rcardenes/FleaFPGA_Replica/FleaFPGA_Ohm_Replica.kicad_pcb

## KiCad design FleaFPGA_Ohm_Replica.kicad_pcb (2024-11-16)

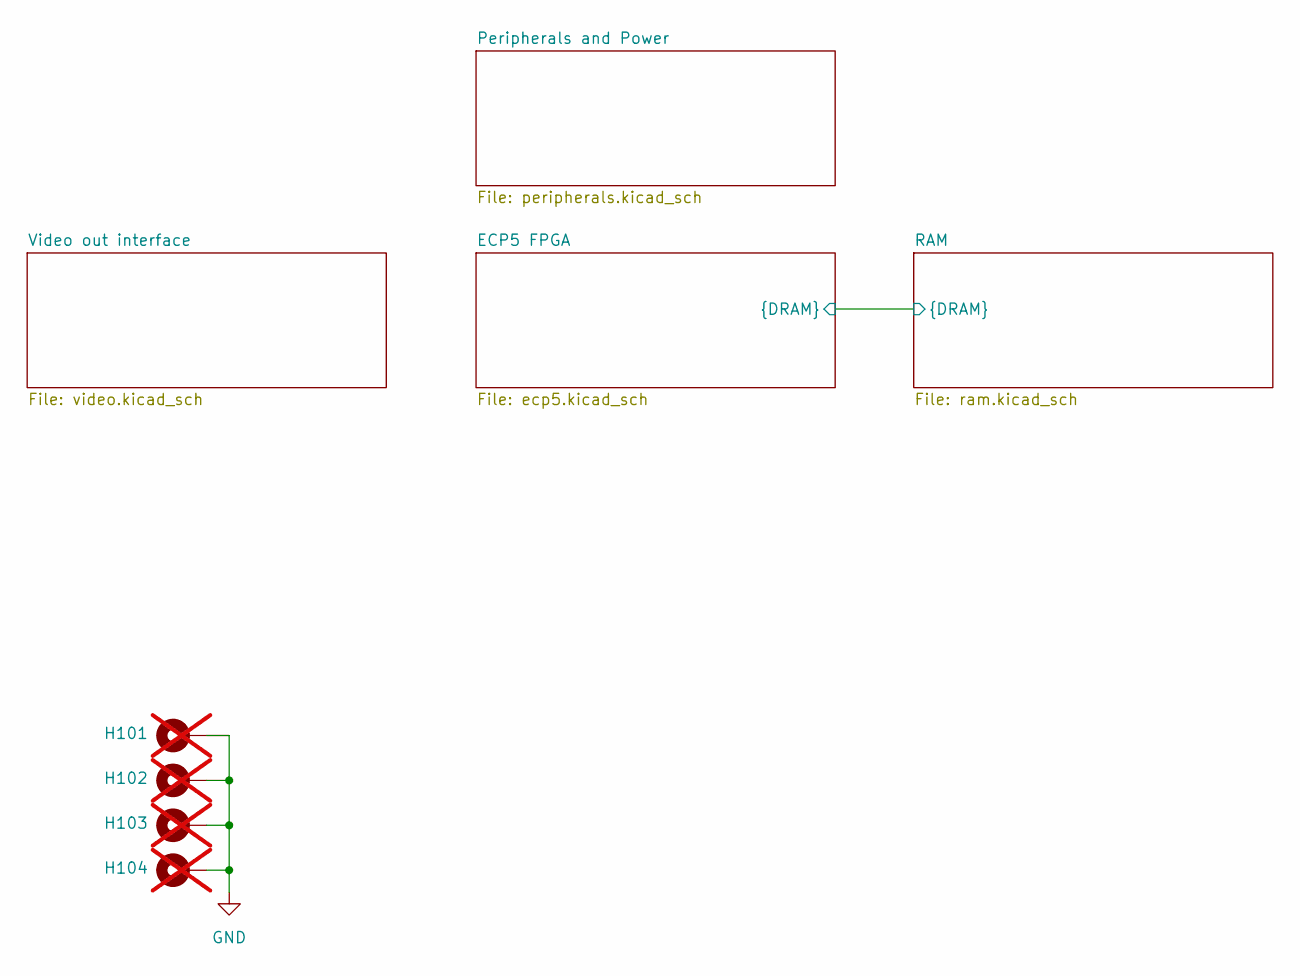
[picture p1: schematic FleaFPGA_Ohm_Replica.kicad_sch]

Parts:
H101, H102, H103, H104: MountingHole_Pad; MountingHole_2.7mm_M2.5_Pad; not fitted

Connections:
GND: H101.1, H102.1, H103.1, H104.1; also elsewhere on the board

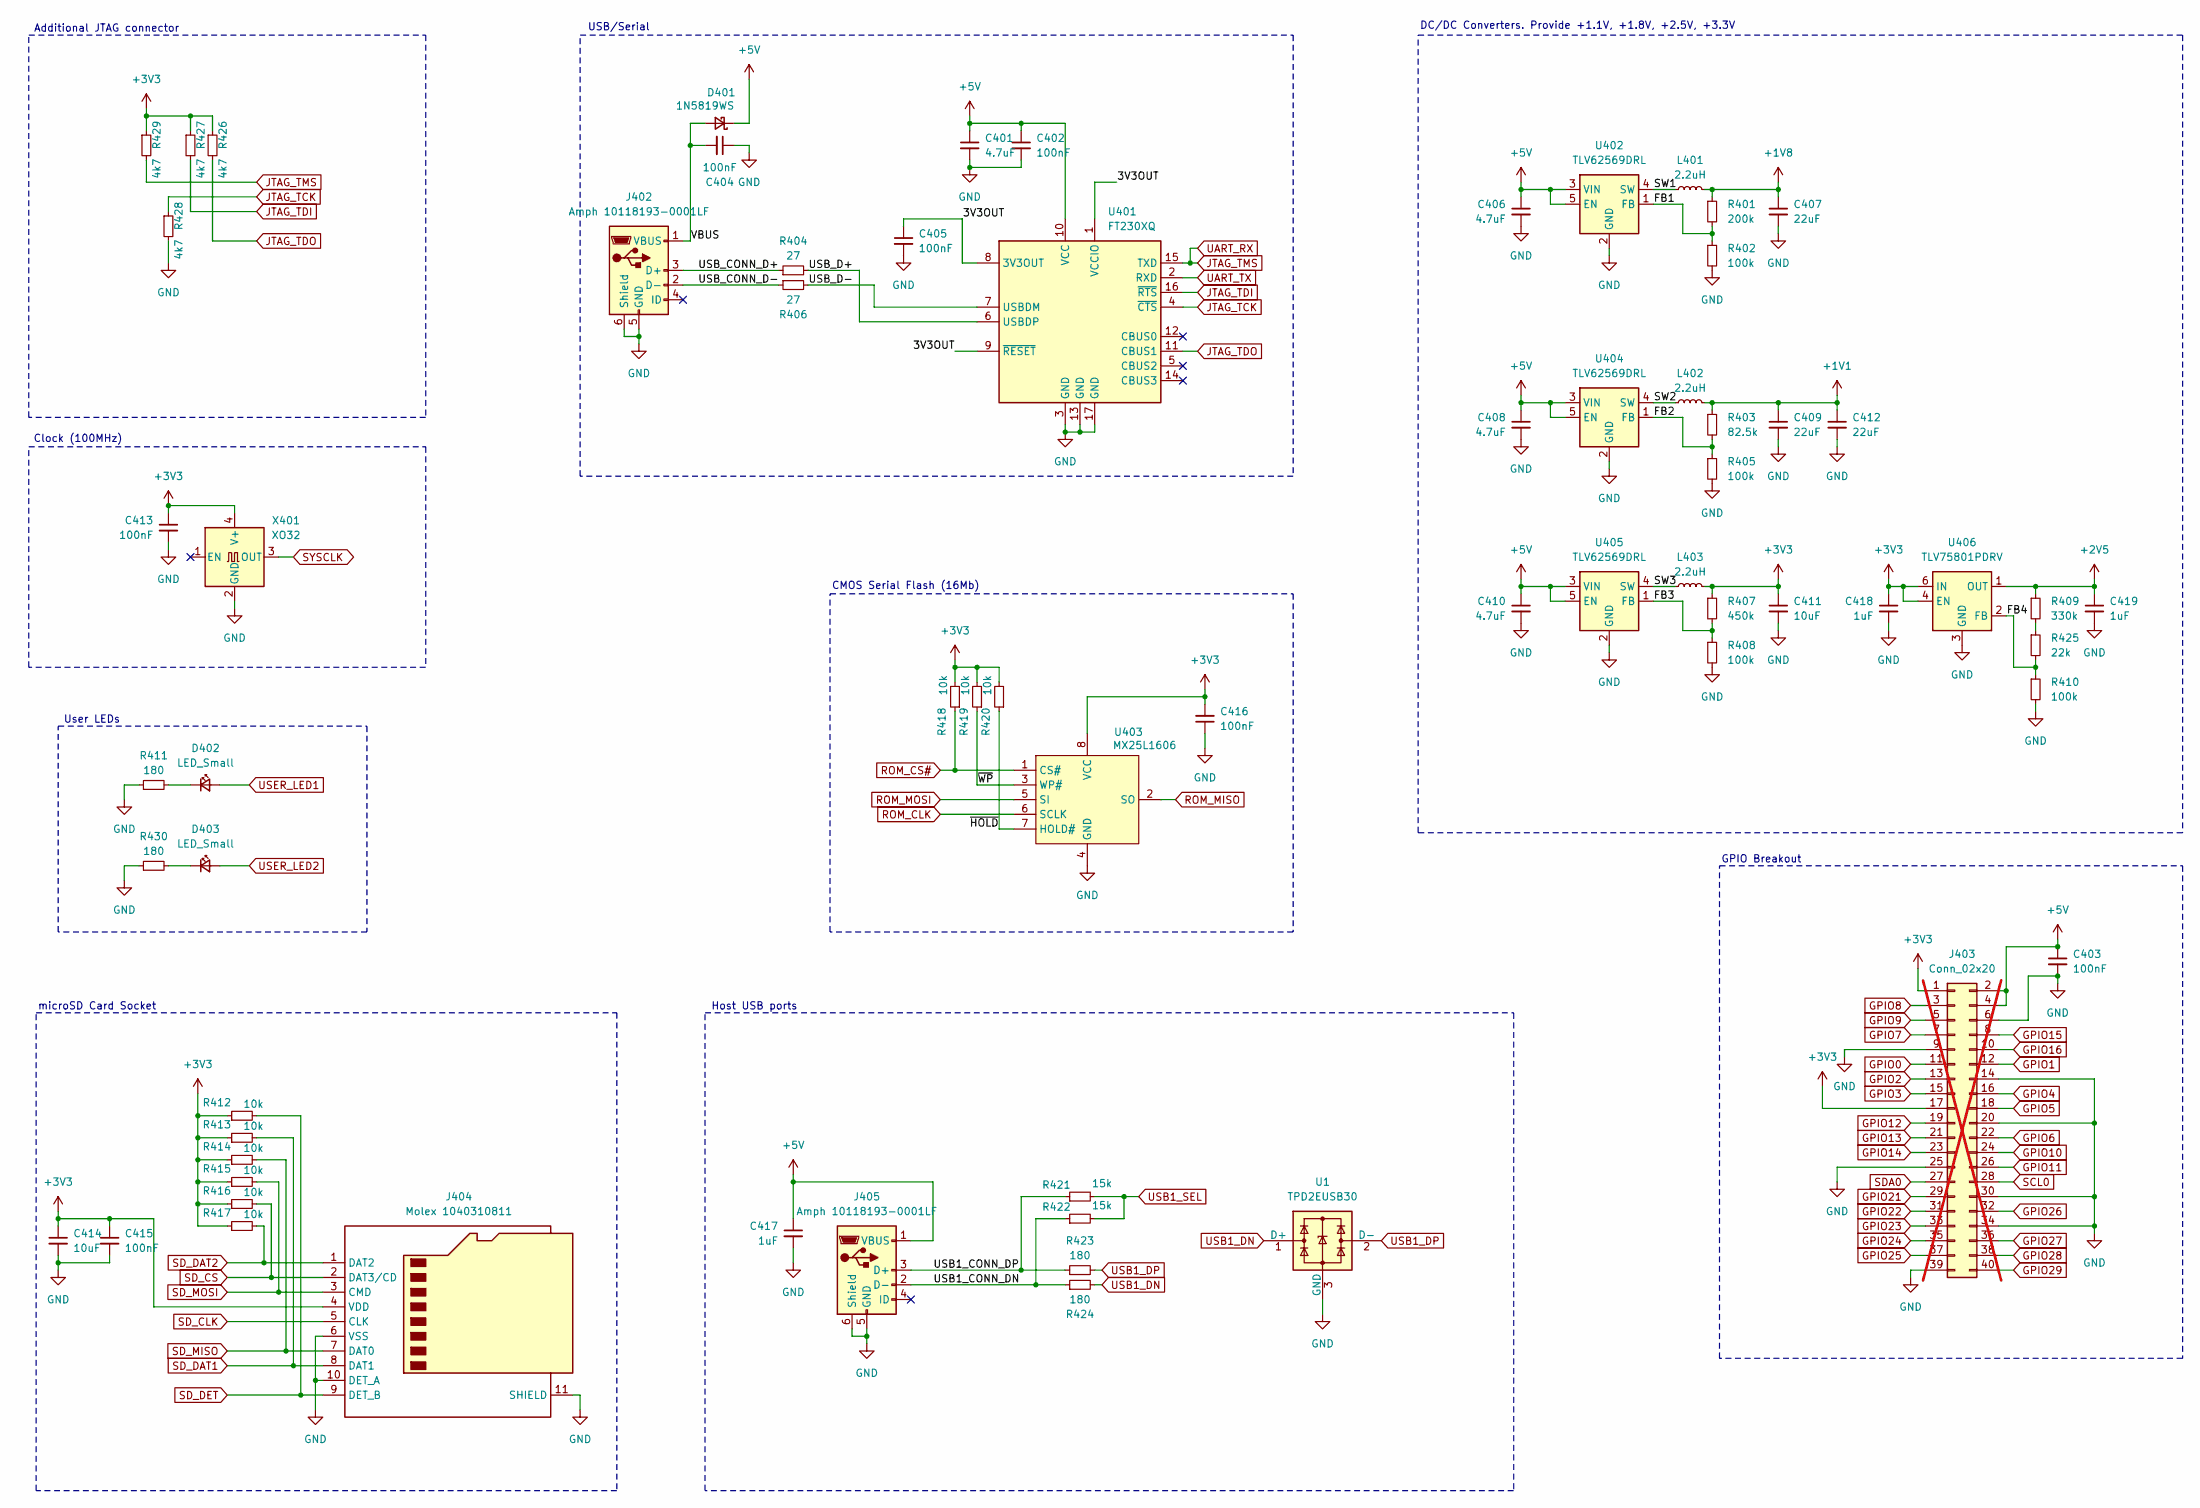
[picture p2: schematic peripherals.kicad_sch]

Parts:
C401, C406, C408, C410: 4.7uF; C_0603_1608Metric; MPN C19666
C402, C405, C413, C415, C416: 100nF; C_0201_0603Metric; MPN C190183
C403: 100nF; C_0603_1608Metric; MPN C14663
C404: 100nF; C_0402_1005Metric; MPN C1525
C407, C409, C412: 22uF; C_0603_1608Metric; MPN C59461
C411, C414: 10uF; C_0603_1608Metric; MPN C19702
C417: 1uF; C_0603_1608Metric; MPN C15849
C418, C419: 1uF; C_0402_1005Metric; MPN C52923
D401: 1N5819WS; D_SOD-323; MPN C191023
D402: LED_Small; LED_0603_1608Metric; MPN C2286
D403: LED_Small; LED_0603_1608Metric; MPN C72038
J402, J405: Amph 10118193-0001LF; USB_Micro-B_Amphenol_10118193-0001LF_Horizontal; MPN C132562
J403: Conn_02x20; PinHeader_2x20_P2.54mm_Vertical; not fitted
J404: Molex 1040310811; microSD_HC_Molex_104031-0811; MPN C585350
L401, L402, L403: 2.2uH; L_0805_2012Metric; MPN C383369
R401: 200k; R_0402_1005Metric; MPN C25764
R402, R405, R408, R410: 100k; R_0402_1005Metric; MPN C25741
R403: 82.5k; R_0402_1005Metric; MPN C11717
R404, R406: 27; R_0402_1005Metric; MPN C25100
R407: 450k; R_0402_1005Metric; MPN C5159688
R409: 330k; R_0603_1608Metric; MPN C23137
R411, R423, R424, R430: 180; R_0402_1005Metric; MPN C138045
R412, R413, R414, R415, R416, R417, R418, R419, R420: 10k; R_0402_1005Metric; MPN C25744
R421, R422: 15k; R_0402_1005Metric; MPN C25756
R425: 22k; R_0402_1005Metric; MPN C25768
R426, R427, R428, R429: 4k7; R_0402_1005Metric
U1: TPD2EUSB30; Texas_DRT-3; MPN C97502
U401: FT230XQ; QFN-16-1EP_4x4mm_P0.65mm_EP2.1x2.1mm; MPN C128629
U402, U404, U405: TLV62569DRL; SOT-563; MPN C163217
U403: MX25L1606; SOP-8-1EP_3.9x4.9mm_P1.27m_EP4.1x3.5mm; MPN C3014050
U406: TLV75801PDRV; WSON-6-1EP_2x2mm_P0.65mm_EP1x1.6mm; MPN C2876308
X401: XO32; Oscillator_SMD_XO32-4Pin_3.2x2.5mm; MPN C4353707

Connections:
+1V1: C409.1, C412.1, L402.2, R403.1; also elsewhere on the board
+1V8: C407.1, L401.2, R401.1; also elsewhere on the board
+2V5: C419.1, R409.1, U406.1 (OUT); also elsewhere on the board
+3V3: C411.1, C413.1, C414.1, C415.1, C416.2, C418.1, J403.1, J403.17, J404.4 (VDD), L403.2, R407.1, R412.1, R413.1, R414.1, R415.1, R416.1, R417.1, R418.2, R419.2, R420.2, R426.1, R427.1, R429.1, U403.8 (VCC), U406.4 (EN), U406.6 (IN), X401.4 (V+); also elsewhere on the board
+5V: C401.1, C402.1, C403.1, C406.1, C408.1, C410.1, C417.1, D401.1 (K), J403.2, J403.4, J405.1 (VBUS), U401.10 (VCC), U402.3 (VIN), U402.5 (EN), U404.3 (VIN), U404.5 (EN), U405.3 (VIN), U405.5 (EN); also elsewhere on the board
/Peripherals and Power/3V3OUT: C405.1, U401.1 (VCCIO), U401.8 (3V3OUT), U401.9 (~RESET)
/Peripherals and Power/FB1: R401.2, R402.1, U402.1 (FB)
/Peripherals and Power/FB2: R403.2, R405.1, U404.1 (FB)
/Peripherals and Power/FB3: R407.2, R408.1, U405.1 (FB)
/Peripherals and Power/FB4: R410.1, R425.2, U406.2 (FB)
/Peripherals and Power/SW1: L401.1, U402.4 (SW)
/Peripherals and Power/SW2: L402.1, U404.4 (SW)
/Peripherals and Power/SW3: L403.1, U405.4 (SW)
/Peripherals and Power/USB1_CONN_DN: J405.2 (D-), R422.1, R424.1
/Peripherals and Power/USB1_CONN_DP: J405.3 (D+), R421.1, R423.1
/Peripherals and Power/USB_CONN_D+: J402.3 (D+), R404.1
/Peripherals and Power/USB_CONN_D-: J402.2 (D-), R406.1
/Peripherals and Power/USB_D+: R404.2, U401.6 (USBDP)
/Peripherals and Power/USB_D-: R406.2, U401.7 (USBDM)
/Peripherals and Power/VBUS: C404.2, D401.2 (A), J402.1 (VBUS)
/Peripherals and Power/~HOLD: R420.1, U403.7 (HOLD#)
/Peripherals and Power/~WP: R419.1, U403.3 (WP#)
GND: C401.2, C402.2, C403.2, C404.1, C405.2, C406.2, C407.2, C408.2, C409.2, C410.2, C411.2, C412.2, C413.2, C414.2, C415.2, C416.1, C417.2, C418.2, C419.2, J402.5 (GND), J402.6 (Shield), J403.6, J403.9, J403.14, J403.20, J403.25, J403.30, J403.34, J403.39, J404.6 (VSS), J404.10 (DET_A), J404.11 (SHIELD), J405.5 (GND), J405.6 (Shield), R402.2, R405.2, R408.2, R410.2, R411.1, R428.2, R430.1, U1.3 (GND), U401.3 (GND), U401.13 (GND), U401.17 (GND), U402.2 (GND), U403.4 (GND), U404.2 (GND), U405.2 (GND), U406.3 (GND), U406.7 (GND), X401.2 (GND); also elsewhere on the board
GPIO0: J403.11; also elsewhere on the board
GPIO1: J403.12; also elsewhere on the board
GPIO2: J403.13; also elsewhere on the board
GPIO3: J403.15; also elsewhere on the board
GPIO4: J403.16; also elsewhere on the board
GPIO5: J403.18; also elsewhere on the board
GPIO6: J403.22; also elsewhere on the board
GPIO7: J403.7; also elsewhere on the board
GPIO8: J403.3; also elsewhere on the board
GPIO9: J403.5; also elsewhere on the board
GPIO10: J403.24; also elsewhere on the board
GPIO11: J403.26; also elsewhere on the board
GPIO12: J403.19; also elsewhere on the board
GPIO13: J403.21; also elsewhere on the board
GPIO14: J403.23; also elsewhere on the board
GPIO15: J403.8; also elsewhere on the board
GPIO16: J403.10; also elsewhere on the board
GPIO21: J403.29; also elsewhere on the board
GPIO22: J403.31; also elsewhere on the board
GPIO23: J403.33; also elsewhere on the board
GPIO24: J403.35
GPIO25: J403.37; also elsewhere on the board
GPIO26: J403.32; also elsewhere on the board
GPIO27: J403.36
GPIO28: J403.38; also elsewhere on the board
GPIO29: J403.40; also elsewhere on the board
JTAG_TCK: R428.1, U401.4 (~CTS); also elsewhere on the board
JTAG_TDI: R427.2, U401.16 (~RTS); also elsewhere on the board
JTAG_TDO: R426.2, U401.11 (CBUS1); also elsewhere on the board
JTAG_TMS: R429.2, U401.15 (TXD); also elsewhere on the board
unnamed: D402.1 (K), R411.2
unnamed: D403.1 (K), R430.2
unnamed: R409.2, R425.1
ROM_CLK: U403.6 (SCLK); also elsewhere on the board
ROM_CS#: R418.1, U403.1 (CS#); also elsewhere on the board
ROM_MISO: U403.2 (SO); also elsewhere on the board
ROM_MOSI: U403.5 (SI); also elsewhere on the board
SCL0: J403.28; also elsewhere on the board
SDA0: J403.27; also elsewhere on the board
SD_CLK: J404.5 (CLK); also elsewhere on the board
SD_CS: J404.2 (DAT3/CD), R416.2; also elsewhere on the board
SD_DAT1: J404.8 (DAT1), R413.2; also elsewhere on the board
SD_DAT2: J404.1 (DAT2), R417.2; also elsewhere on the board
SD_DET: J404.9 (DET_B), R412.2; also elsewhere on the board
SD_MISO: J404.7 (DAT0), R414.2; also elsewhere on the board
SD_MOSI: J404.3 (CMD), R415.2; also elsewhere on the board
SYSCLK: X401.3 (OUT); also elsewhere on the board
UART_TX: U401.2 (RXD); also elsewhere on the board
USB1_DN: R424.2, U1.1 (D+); also elsewhere on the board
USB1_DP: R423.2, U1.2 (D-); also elsewhere on the board
USB1_SEL: R421.2, R422.2; also elsewhere on the board
USER_LED1: D402.2 (A); also elsewhere on the board
USER_LED2: D403.2 (A); also elsewhere on the board

Notes on the sheet:
User LEDs
microSD Card Socket
Clock (100MHz)
Additional JTAG connector
USB/Serial
Host USB ports
CMOS Serial Flash (16Mb)
DC/DC Converters. Provide +1.1V, +1.8V, +2.5V, +3.3V
GPIO Breakout

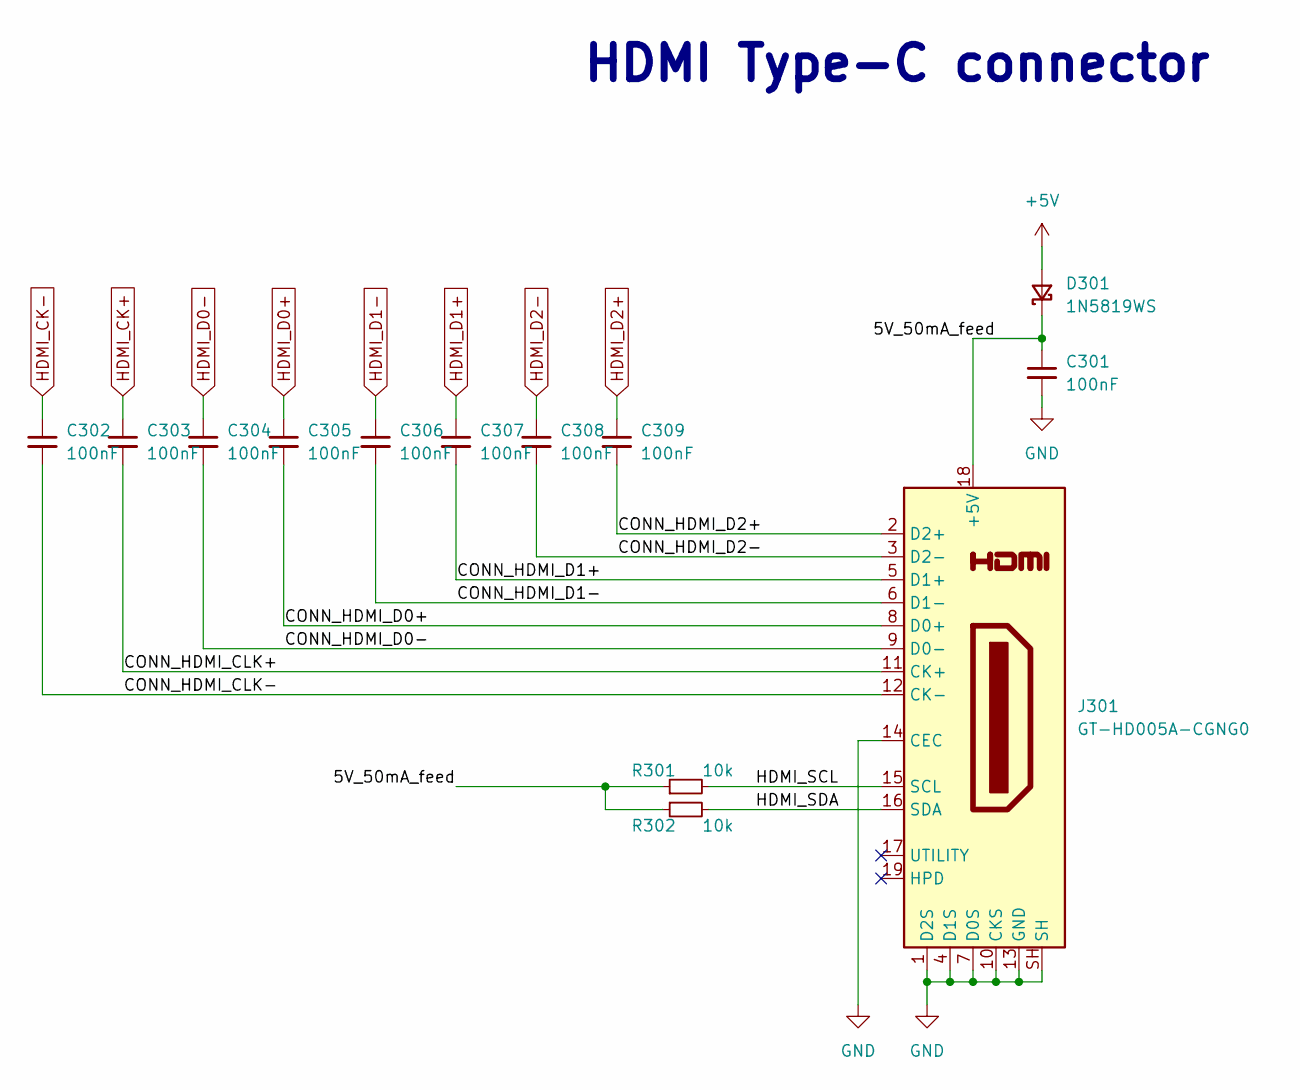
[picture p3: schematic video.kicad_sch]

Parts:
C301, C302, C303, C304, C305, C306, C307, C308, C309: 100nF; C_0201_0603Metric; MPN C190183
D301: 1N5819WS; D_SOD-323; MPN C191023
J301: GT-HD005A-CGNG0; GT-HD005A; MPN C27636754
R301, R302: 10k; R_0402_1005Metric; MPN C25744

Connections:
+5V: D301.2 (A); also elsewhere on the board
/Video out interface/5V_50mA_feed: C301.1, D301.1 (K), J301.18 (+5V), R301.1, R302.1
/Video out interface/CONN_HDMI_CLK+: C303.2, J301.11 (CK+)
/Video out interface/CONN_HDMI_CLK-: C302.2, J301.12 (CK-)
/Video out interface/CONN_HDMI_D0+: C305.2, J301.8 (D0+)
/Video out interface/CONN_HDMI_D0-: C304.2, J301.9 (D0-)
/Video out interface/CONN_HDMI_D1+: C307.2, J301.5 (D1+)
/Video out interface/CONN_HDMI_D1-: C306.2, J301.6 (D1-)
/Video out interface/CONN_HDMI_D2+: C309.2, J301.2 (D2+)
/Video out interface/CONN_HDMI_D2-: C308.2, J301.3 (D2-)
/Video out interface/HDMI_SCL: J301.15 (SCL), R301.2
/Video out interface/HDMI_SDA: J301.16 (SDA), R302.2
GND: C301.2, J301.1 (D2S), J301.4 (D1S), J301.7 (D0S), J301.10 (CKS), J301.13 (GND), J301.14 (CEC), J301.SH; also elsewhere on the board
HDMI_CK+: C303.1; also elsewhere on the board
HDMI_CK-: C302.1; also elsewhere on the board
HDMI_D0+: C305.1; also elsewhere on the board
HDMI_D0-: C304.1; also elsewhere on the board
HDMI_D1+: C307.1; also elsewhere on the board
HDMI_D1-: C306.1; also elsewhere on the board
HDMI_D2+: C309.1; also elsewhere on the board
HDMI_D2-: C308.1; also elsewhere on the board

Notes on the sheet:
HDMI Type-C connector

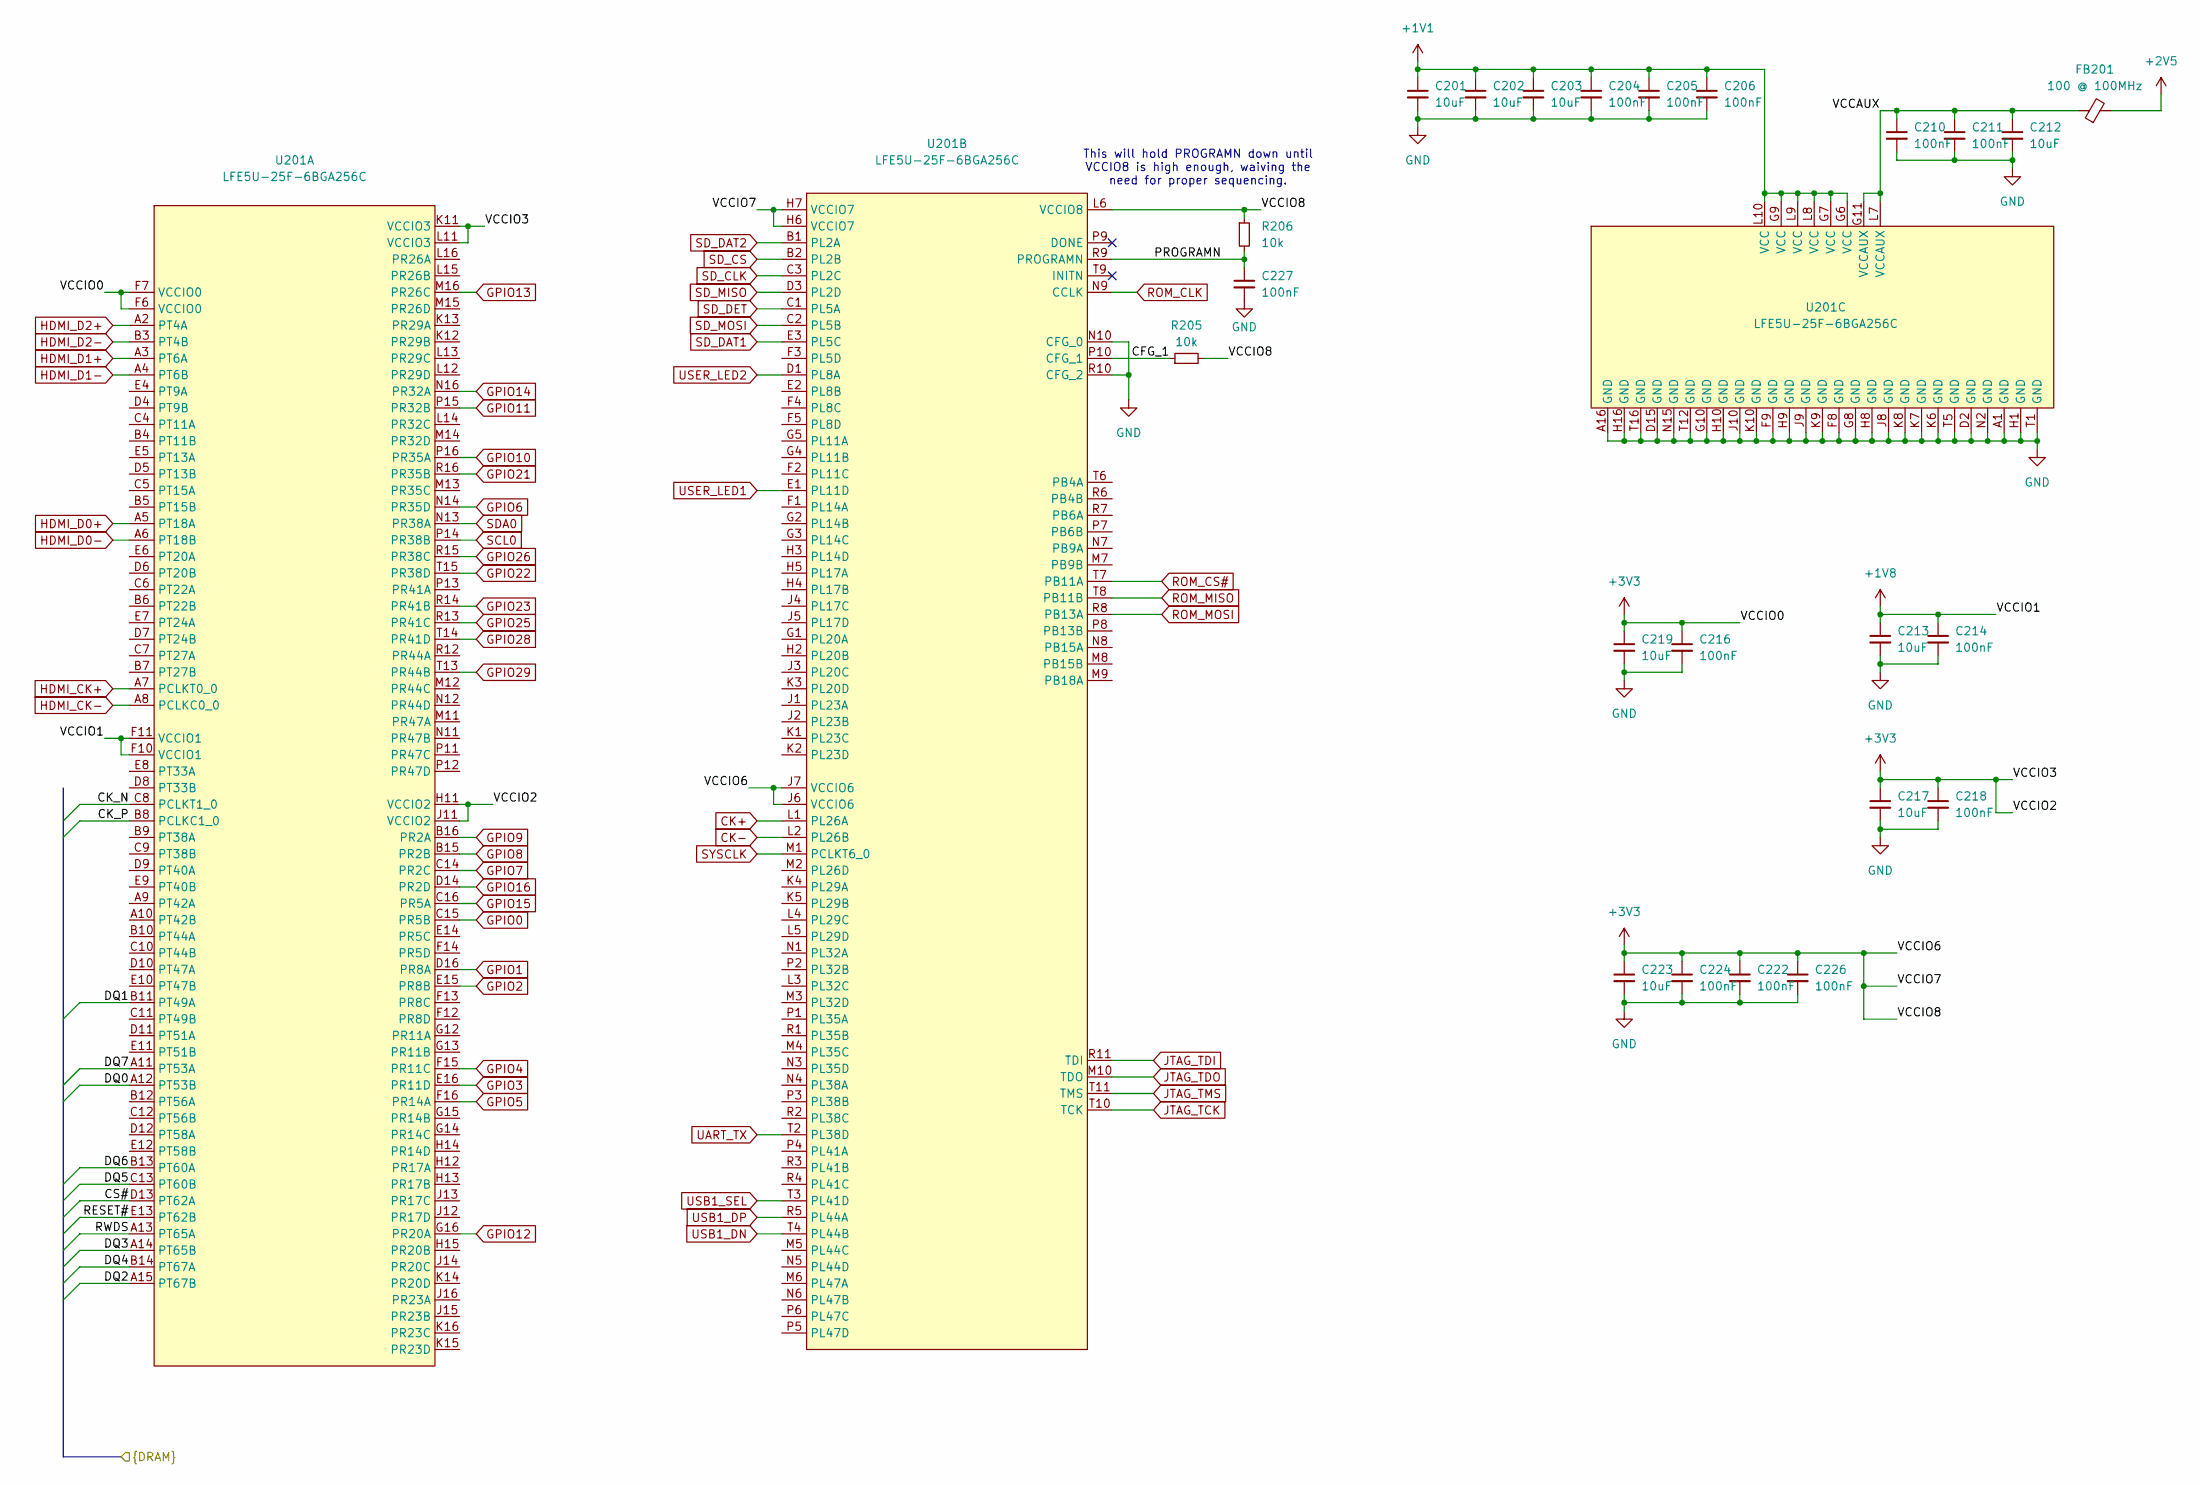
[picture p4: schematic ecp5.kicad_sch]

Parts:
C201, C202, C203, C212, C213, C217, C219, C223: 10uF; C_0402_1005Metric; MPN C15525
C204, C205, C206, C210, C211, C214, C216, C218, C222, C224, C226, C227: 100nF; C_0201_0603Metric; MPN C190183
FB201: 100 @ 100MHz; L_0805_2012Metric; MPN C1015
R205, R206: 10k; R_0201_0603Metric; MPN C473048
U201: LFE5U-25F-6BGA256C; Lattice_caBGA-256_14.0x14.0mm_Layout16x16_P0.8mm; MPN C1521614

Connections:
+1V1: C201.1, C202.1, C203.1, C204.1, C205.1, C206.1, U201.G6 (VCC), U201.G7 (VCC), U201.G9 (VCC), U201.L8 (VCC), U201.L9 (VCC), U201.L10 (VCC); also elsewhere on the board
+1V8: C213.1, C214.1, U201.F10 (VCCIO1), U201.F11 (VCCIO1); also elsewhere on the board
+2V5: FB201.2; also elsewhere on the board
+3V3: C216.1, C217.1, C218.1, C219.1, C222.1, C223.1, C224.1, C226.1, R205.2, R206.1, U201.F6 (VCCIO0), U201.F7 (VCCIO0), U201.H6 (VCCIO7), U201.H7 (VCCIO7), U201.H11 (VCCIO2), U201.J6 (VCCIO6), U201.J7 (VCCIO6), U201.J11 (VCCIO2), U201.K11 (VCCIO3), U201.L6 (VCCIO8), U201.L11 (VCCIO3); also elsewhere on the board
/ECP5 FPGA/CFG_1: R205.1, U201.P10 (CFG_1)
/ECP5 FPGA/CK_N: U201.C8 (PCLKT1_0); also elsewhere on the board
/ECP5 FPGA/CK_P: U201.B8 (PCLKC1_0); also elsewhere on the board
/ECP5 FPGA/CS#: U201.D13 (PT62A); also elsewhere on the board
/ECP5 FPGA/DQ0: U201.A12 (PT53B); also elsewhere on the board
/ECP5 FPGA/DQ1: U201.B11 (PT49A); also elsewhere on the board
/ECP5 FPGA/DQ2: U201.A15 (PT67B); also elsewhere on the board
/ECP5 FPGA/DQ3: U201.A14 (PT65B); also elsewhere on the board
/ECP5 FPGA/DQ4: U201.B14 (PT67A); also elsewhere on the board
/ECP5 FPGA/DQ5: U201.C13 (PT60B); also elsewhere on the board
/ECP5 FPGA/DQ6: U201.B13 (PT60A); also elsewhere on the board
/ECP5 FPGA/DQ7: U201.A11 (PT53A); also elsewhere on the board
/ECP5 FPGA/PROGRAMN: C227.1, R206.2, U201.R9 (PROGRAMN)
/ECP5 FPGA/RESET#: U201.E13 (PT62B); also elsewhere on the board
/ECP5 FPGA/RWDS: U201.A13 (PT65A); also elsewhere on the board
/ECP5 FPGA/VCCAUX: C210.1, C211.1, C212.1, FB201.1, U201.G11 (VCCAUX), U201.L7 (VCCAUX)
CK+: U201.L1 (PL26A)
CK-: U201.L2 (PL26B)
GND: C201.2, C202.2, C203.2, C204.2, C205.2, C206.2, C210.2, C211.2, C212.2, C213.2, C214.2, C216.2, C217.2, C218.2, C219.2, C222.2, C223.2, C224.2, C226.2, C227.2, U201.A1 (GND), U201.A16 (GND), U201.D2 (GND), U201.D15 (GND), U201.F8 (GND), U201.F9 (GND), U201.G8 (GND), U201.G10 (GND), U201.H1 (GND), U201.H8 (GND), U201.H9 (GND), U201.H10 (GND), U201.H16 (GND), U201.J8 (GND), U201.J9 (GND), U201.J10 (GND), U201.K6 (GND), U201.K7 (GND), U201.K8 (GND), U201.K9 (GND), U201.K10 (GND), U201.N2 (GND), U201.N10 (CFG_0), U201.N15 (GND), U201.R10 (CFG_2), U201.T1 (GND), U201.T5 (GND), U201.T12 (GND), U201.T16 (GND); also elsewhere on the board
GPIO0: U201.C15 (PR5B); also elsewhere on the board
GPIO1: U201.D16 (PR8A); also elsewhere on the board
GPIO2: U201.E15 (PR8B); also elsewhere on the board
GPIO3: U201.E16 (PR11D); also elsewhere on the board
GPIO4: U201.F15 (PR11C); also elsewhere on the board
GPIO5: U201.F16 (PR14A); also elsewhere on the board
GPIO6: U201.N14 (PR35D); also elsewhere on the board
GPIO7: U201.C14 (PR2C); also elsewhere on the board
GPIO8: U201.B15 (PR2B); also elsewhere on the board
GPIO9: U201.B16 (PR2A); also elsewhere on the board
GPIO10: U201.P16 (PR35A); also elsewhere on the board
GPIO11: U201.P15 (PR32B); also elsewhere on the board
GPIO12: U201.G16 (PR20A); also elsewhere on the board
GPIO13: U201.M16 (PR26C); also elsewhere on the board
GPIO14: U201.N16 (PR32A); also elsewhere on the board
GPIO15: U201.C16 (PR5A); also elsewhere on the board
GPIO16: U201.D14 (PR2D); also elsewhere on the board
GPIO21: U201.R16 (PR35B); also elsewhere on the board
GPIO22: U201.T15 (PR38D); also elsewhere on the board
GPIO23: U201.R14 (PR41B); also elsewhere on the board
GPIO25: U201.R13 (PR41C); also elsewhere on the board
GPIO26: U201.R15 (PR38C); also elsewhere on the board
GPIO28: U201.T14 (PR41D); also elsewhere on the board
GPIO29: U201.T13 (PR44B); also elsewhere on the board
HDMI_CK+: U201.A7 (PCLKT0_0); also elsewhere on the board
HDMI_CK-: U201.A8 (PCLKC0_0); also elsewhere on the board
HDMI_D0+: U201.A5 (PT18A); also elsewhere on the board
HDMI_D0-: U201.A6 (PT18B); also elsewhere on the board
HDMI_D1+: U201.A3 (PT6A); also elsewhere on the board
HDMI_D1-: U201.A4 (PT6B); also elsewhere on the board
HDMI_D2+: U201.A2 (PT4A); also elsewhere on the board
HDMI_D2-: U201.B3 (PT4B); also elsewhere on the board
JTAG_TCK: U201.T10 (TCK); also elsewhere on the board
JTAG_TDI: U201.R11 (TDI); also elsewhere on the board
JTAG_TDO: U201.M10 (TDO); also elsewhere on the board
JTAG_TMS: U201.T11 (TMS); also elsewhere on the board
ROM_CLK: U201.N9 (CCLK); also elsewhere on the board
ROM_CS#: U201.T7 (PB11A); also elsewhere on the board
ROM_MISO: U201.T8 (PB11B); also elsewhere on the board
ROM_MOSI: U201.R8 (PB13A); also elsewhere on the board
SCL0: U201.P14 (PR38B); also elsewhere on the board
SDA0: U201.N13 (PR38A); also elsewhere on the board
SD_CLK: U201.C3 (PL2C); also elsewhere on the board
SD_CS: U201.B2 (PL2B); also elsewhere on the board
SD_DAT1: U201.E3 (PL5C); also elsewhere on the board
SD_DAT2: U201.B1 (PL2A); also elsewhere on the board
SD_DET: U201.C1 (PL5A); also elsewhere on the board
SD_MISO: U201.D3 (PL2D); also elsewhere on the board
SD_MOSI: U201.C2 (PL5B); also elsewhere on the board
SYSCLK: U201.M1 (PCLKT6_0); also elsewhere on the board
UART_TX: U201.T2 (PL38D); also elsewhere on the board
USB1_DN: U201.T4 (PL44B); also elsewhere on the board
USB1_DP: U201.R5 (PL44A); also elsewhere on the board
USB1_SEL: U201.T3 (PL41D); also elsewhere on the board
USER_LED1: U201.E1 (PL11D); also elsewhere on the board
USER_LED2: U201.D1 (PL8A); also elsewhere on the board

Notes on the sheet:
This will hold PROGRAMN down until VCCIO8 is high enough, waiving the need for proper sequencing.

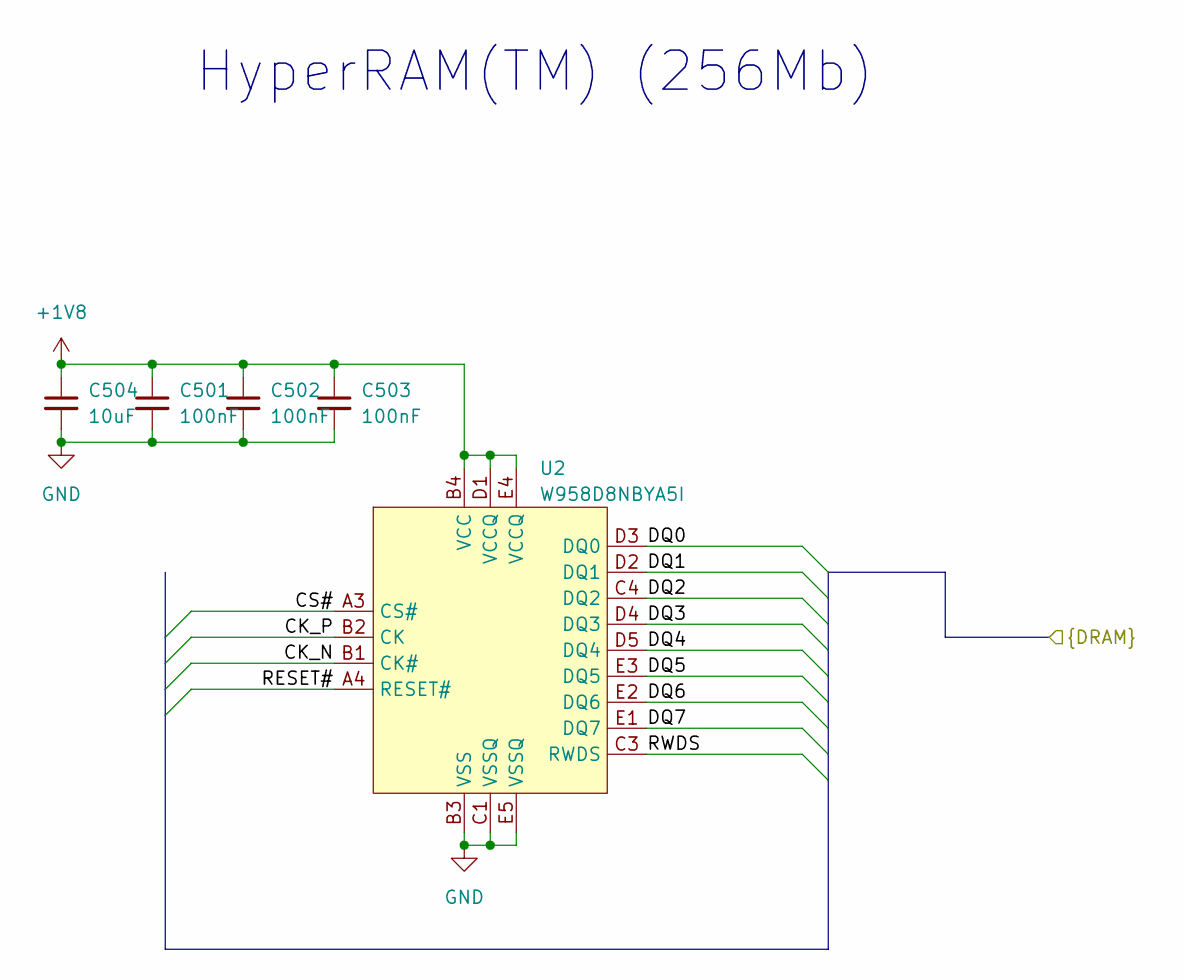
[picture p5: schematic ram.kicad_sch]

Parts:
C501, C502, C503: 100nF; C_0402_1005Metric; MPN C1525
C504: 10uF; C_0402_1005Metric; MPN C15525
U2: W958D8NBYA5I; FBGA-25_8x6mm_Layout5x6_P1mm; MPN C7420405

Connections:
+1V8: C501.1, C502.1, C503.1, C504.1, U2.B4 (VCC), U2.D1 (VCCQ), U2.E4 (VCCQ); also elsewhere on the board
/ECP5 FPGA/CK_N: U2.B1 (CK#); also elsewhere on the board
/ECP5 FPGA/CK_P: U2.B2 (CK); also elsewhere on the board
/ECP5 FPGA/CS#: U2.A3 (CS#); also elsewhere on the board
/ECP5 FPGA/DQ0: U2.D3 (DQ0); also elsewhere on the board
/ECP5 FPGA/DQ1: U2.D2 (DQ1); also elsewhere on the board
/ECP5 FPGA/DQ2: U2.C4 (DQ2); also elsewhere on the board
/ECP5 FPGA/DQ3: U2.D4 (DQ3); also elsewhere on the board
/ECP5 FPGA/DQ4: U2.D5 (DQ4); also elsewhere on the board
/ECP5 FPGA/DQ5: U2.E3 (DQ5); also elsewhere on the board
/ECP5 FPGA/DQ6: U2.E2 (DQ6); also elsewhere on the board
/ECP5 FPGA/DQ7: U2.E1 (DQ7); also elsewhere on the board
/ECP5 FPGA/RESET#: U2.A4 (RESET#); also elsewhere on the board
/ECP5 FPGA/RWDS: U2.C3 (RWDS); also elsewhere on the board
GND: C501.2, C502.2, C503.2, C504.2, U2.B3 (VSS), U2.C1 (VSSQ), U2.E5 (VSSQ); also elsewhere on the board

Notes on the sheet:
HyperRAM(TM) (256Mb)

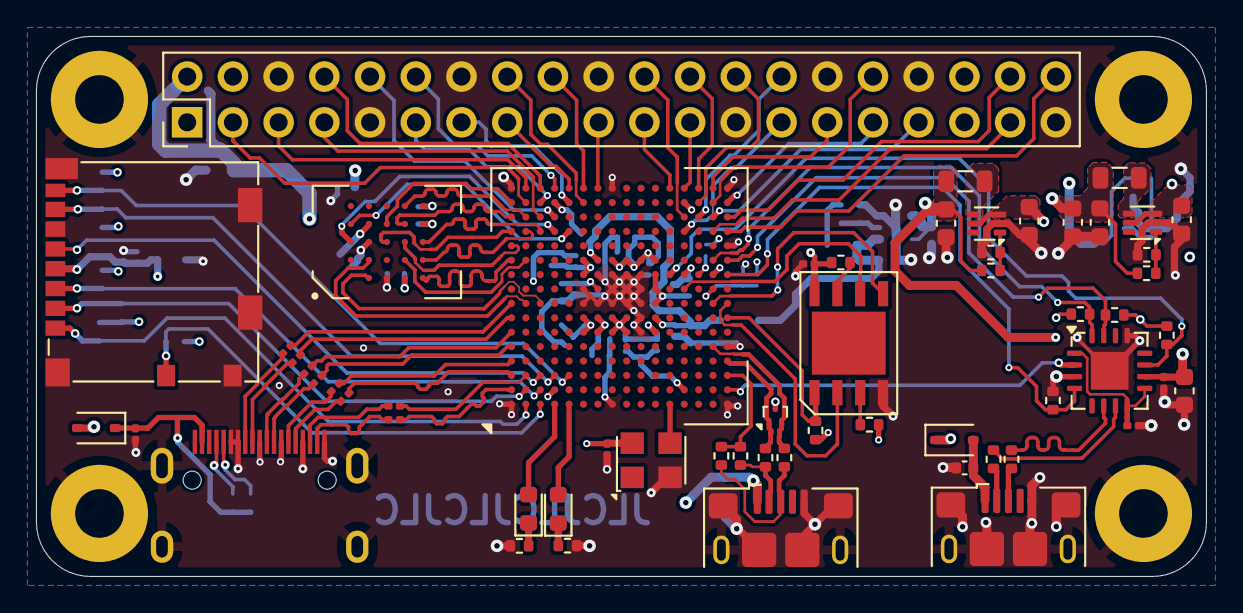
[picture p6: board FleaFPGA_Ohm_Replica.kicad_pcb from above]

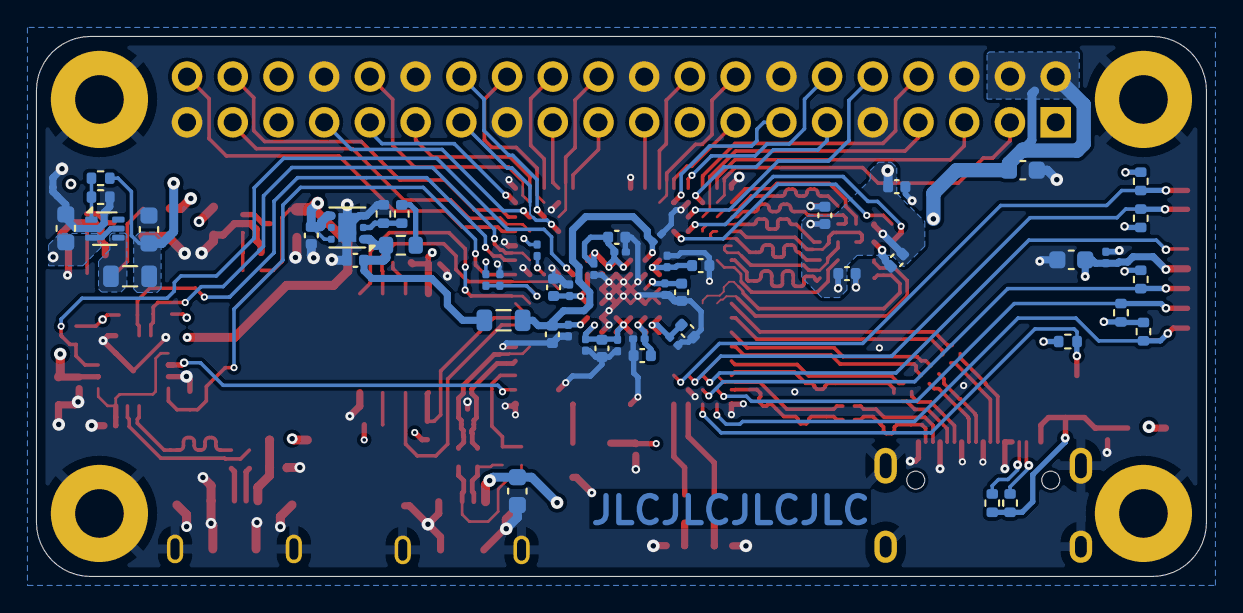
[picture p7: board FleaFPGA_Ohm_Replica.kicad_pcb from below]

Board: 4 copper layers, 65.0 x 30.0 mm, 113 parts (51 on the bottom side), 109 nets.
