rcardenes/FleaFPGA_Replica/(commit log)

2024-09-13 First round at adapting the schematic. Missing the FPGA pads
    [FleaFPGA_Ohm_Replica.kicad_pcb, FleaFPGA_Ohm_Replica.kicad_sch, ecp5.kicad_sch, peripherals.kicad_sch, video.kicad_sch]
2024-09-20 Towards routing RAM
    - Moved the RAM to its own sheet
    - Use the ECP5 prefix to capture impedance controlled traces
    [FleaFPGA_Ohm_Replica.kicad_pcb, FleaFPGA_Ohm_Replica.kicad_sch, ecp5.kicad_sch, peripherals.kicad_sch, ram.kicad_sch]
2024-10-08 First whole routing
    [FleaFPGA_Ohm_Replica.kicad_pcb, FleaFPGA_Ohm_Replica.kicad_sch, ecp5.kicad_sch, peripherals.kicad_sch, ram.kicad_sch, video.kicad_sch]
2024-10-09 Update some component values and complete MPN for BOM
    [FleaFPGA_Ohm_Replica.kicad_pcb, FleaFPGA_Ohm_Replica.kicad_sch, ecp5.kicad_sch, peripherals.kicad_sch, ram.kicad_sch, video.kicad_sch]
2024-10-11 Last minute changes before sending to JLCPCB
    [FleaFPGA_Ohm_Replica.kicad_pcb, ecp5.kicad_sch, ram.kicad_sch]
2024-11-16 Minor fixes
    [FleaFPGA_Ohm_Replica.kicad_pcb, FleaFPGA_Ohm_Replica.kicad_sch, ecp5.kicad_sch, peripherals.kicad_sch]
